gsuckz/SSCS-Chipathon-2025_AC3E-Chile-team/README.md

# SSCS-Chipathon-2025_AC3E-Chile-team
SSCS-Chipathon-2025 repository for the AC3E-Chile team
