gsuckz/SSCS-Chipathon-2025_AC3E-Chile-team/(commit log)

2025-07-05 Added VCO, first version
    [Esm22_CMOSVCOlowG_v4p2_IHP.sch, stage_v2p1_IHP.sch, tb_CMOSVCO_v4p2_IHP.sch]
2025-07-12 changed VCO name from IHOP to GF180
    [Esm22_CMOSVCOlowG_v4p2_GF180.sch, stage_v2p1_GF180.sch, tb_CMOSVCO_v4p2_GF180.sch]
2025-07-14 updated VCO names (IHP --> GF180), added current attempts in stdcell use in large_delay folder, and added initial tgate Ron/leakage measurements in tgate folder
    [large_delay_vto1p1.sch, tb_largedelay_vto1p1.sch, tb_mcu7t5v0__dlyd_4_vto1p1.sch, tb_transmission_gate.sch, transmission_gate.sch]
2025-07-18 Added xschem/IHP_digital/ folder with IHP digital modules
    [NOL2DT_vto1p1.sch, NOL_vto1p1.sch, PD_vto1p1.sch, SPG_vto1p1.sch, large_delay_vto1p1.sch, tb_NOL2DT_vto1p1.sch, tb_NOL_vto1p1.sch, tb_PD_vto1p1.sch]
2025-07-26 added gd
    [GD_vto2p1.sch, tb_GD_vto1v1.sch]
2025-07-27 added TG testbench
    [tgate_lv_isweep_tb.sch, tgate_lv_vsweep_tb.sch, transmission_gate.sch]
2025-07-27 update tgate_lv_vsweep
    [tgate_lv_vsweep_tb.sch]
2025-07-28 added first dlyx cells in large_delay directory and updated testbench, works now
    [large_delay_vto1p1.sch, largedelay-inv_vto1p1.sch, tb_inv.sch, tb_large_delay_vto1p1.sch, tb_largedelay-inv_vto1p1.sch, tb_largedelay-inv_vto2p1.sch]
2025-08-08 added gf180_digital
    [NOL2DT_vto1p1.sch, NOL_vto1p1.sch, PD_vto1p1.sch, SPG_vto1p1.sch, large_delay_vto1p1.sch, tb_NOL2DT_vto1p1.sch, tb_NOL_vto1p1.sch, tb_PD_vto1p1.sch]
2025-08-15 Added 5V oscillators
    [Esm22_CMOSVCOlowG_v5p1_GF180-5V.sch, stage_v3p1_GF180-5V.sch, tb_CMOSVCO_v5p1_GF180-5V.sch]
2025-08-16 Added PS and GD
    Added power stage test bench and gate driver schematic and symbol under pwr_stage directory. Includes python file for analyzing efficiency data.
    [GD_schem.sch, TB_DCDCBuck_GD_FR_2.sch]
2025-08-16 Added top-level simulation
    [Esm22_CMOSVCOlowG_v5p1_GF180-5V.sch, PD_vto1p1.sch, SPG_vto1p1.sch, TB_DCDCBuck_GD_FR_2.sch, stage_v3p1_GF180-5V.sch, tb_CMOSVCO_v5p1_GF180-5V.sch, tb_TDBuckTOP-IHP-CL_v3p3.sch]
2025-09-01 xschemrc & main.sch
    [Esm22_CMOSVCOlowG_v4p2_GF180.sch, NOL_vto1p1.sch, large_delay_vto1p1.sch, main.sch, tb_CMOSVCO_v4p2_GF180.sch, tb_GD_vto1v1.sch, tb_NOL_vto1p1.sch, tb_transmission_gate.sch]
2025-09-10 io_pad tb tgate
    [bi_t_tran_tb.sch]
2025-09-16 TOP sim PAD
    [PWR_MOSbius-TOP.sch, PWR_MOSbius-TOP_noPAD.sch, bi_t_tran_tb.sch, mux2.sch, tb_TDBuckTOP-IHP-CL_v3p3.sch, tb_TDBuckTOP-IHP-CL_v3p3_NOL.sch, tb_TDBuckTOP-IHP-CL_v3p3_NOLnoPAD.sch, untitled.sch]
2025-09-17 TOP sim noPAD
    [PWR_MOSbius-TOP_noPAD.sch, tb_TDBuckTOP-IHP-CL_v3p3_NOLnoPAD.sch]
